buelowp/trainstation/pcb/village_control.brd

## EAGLE design pcb/village_control.brd (2020-09-09)

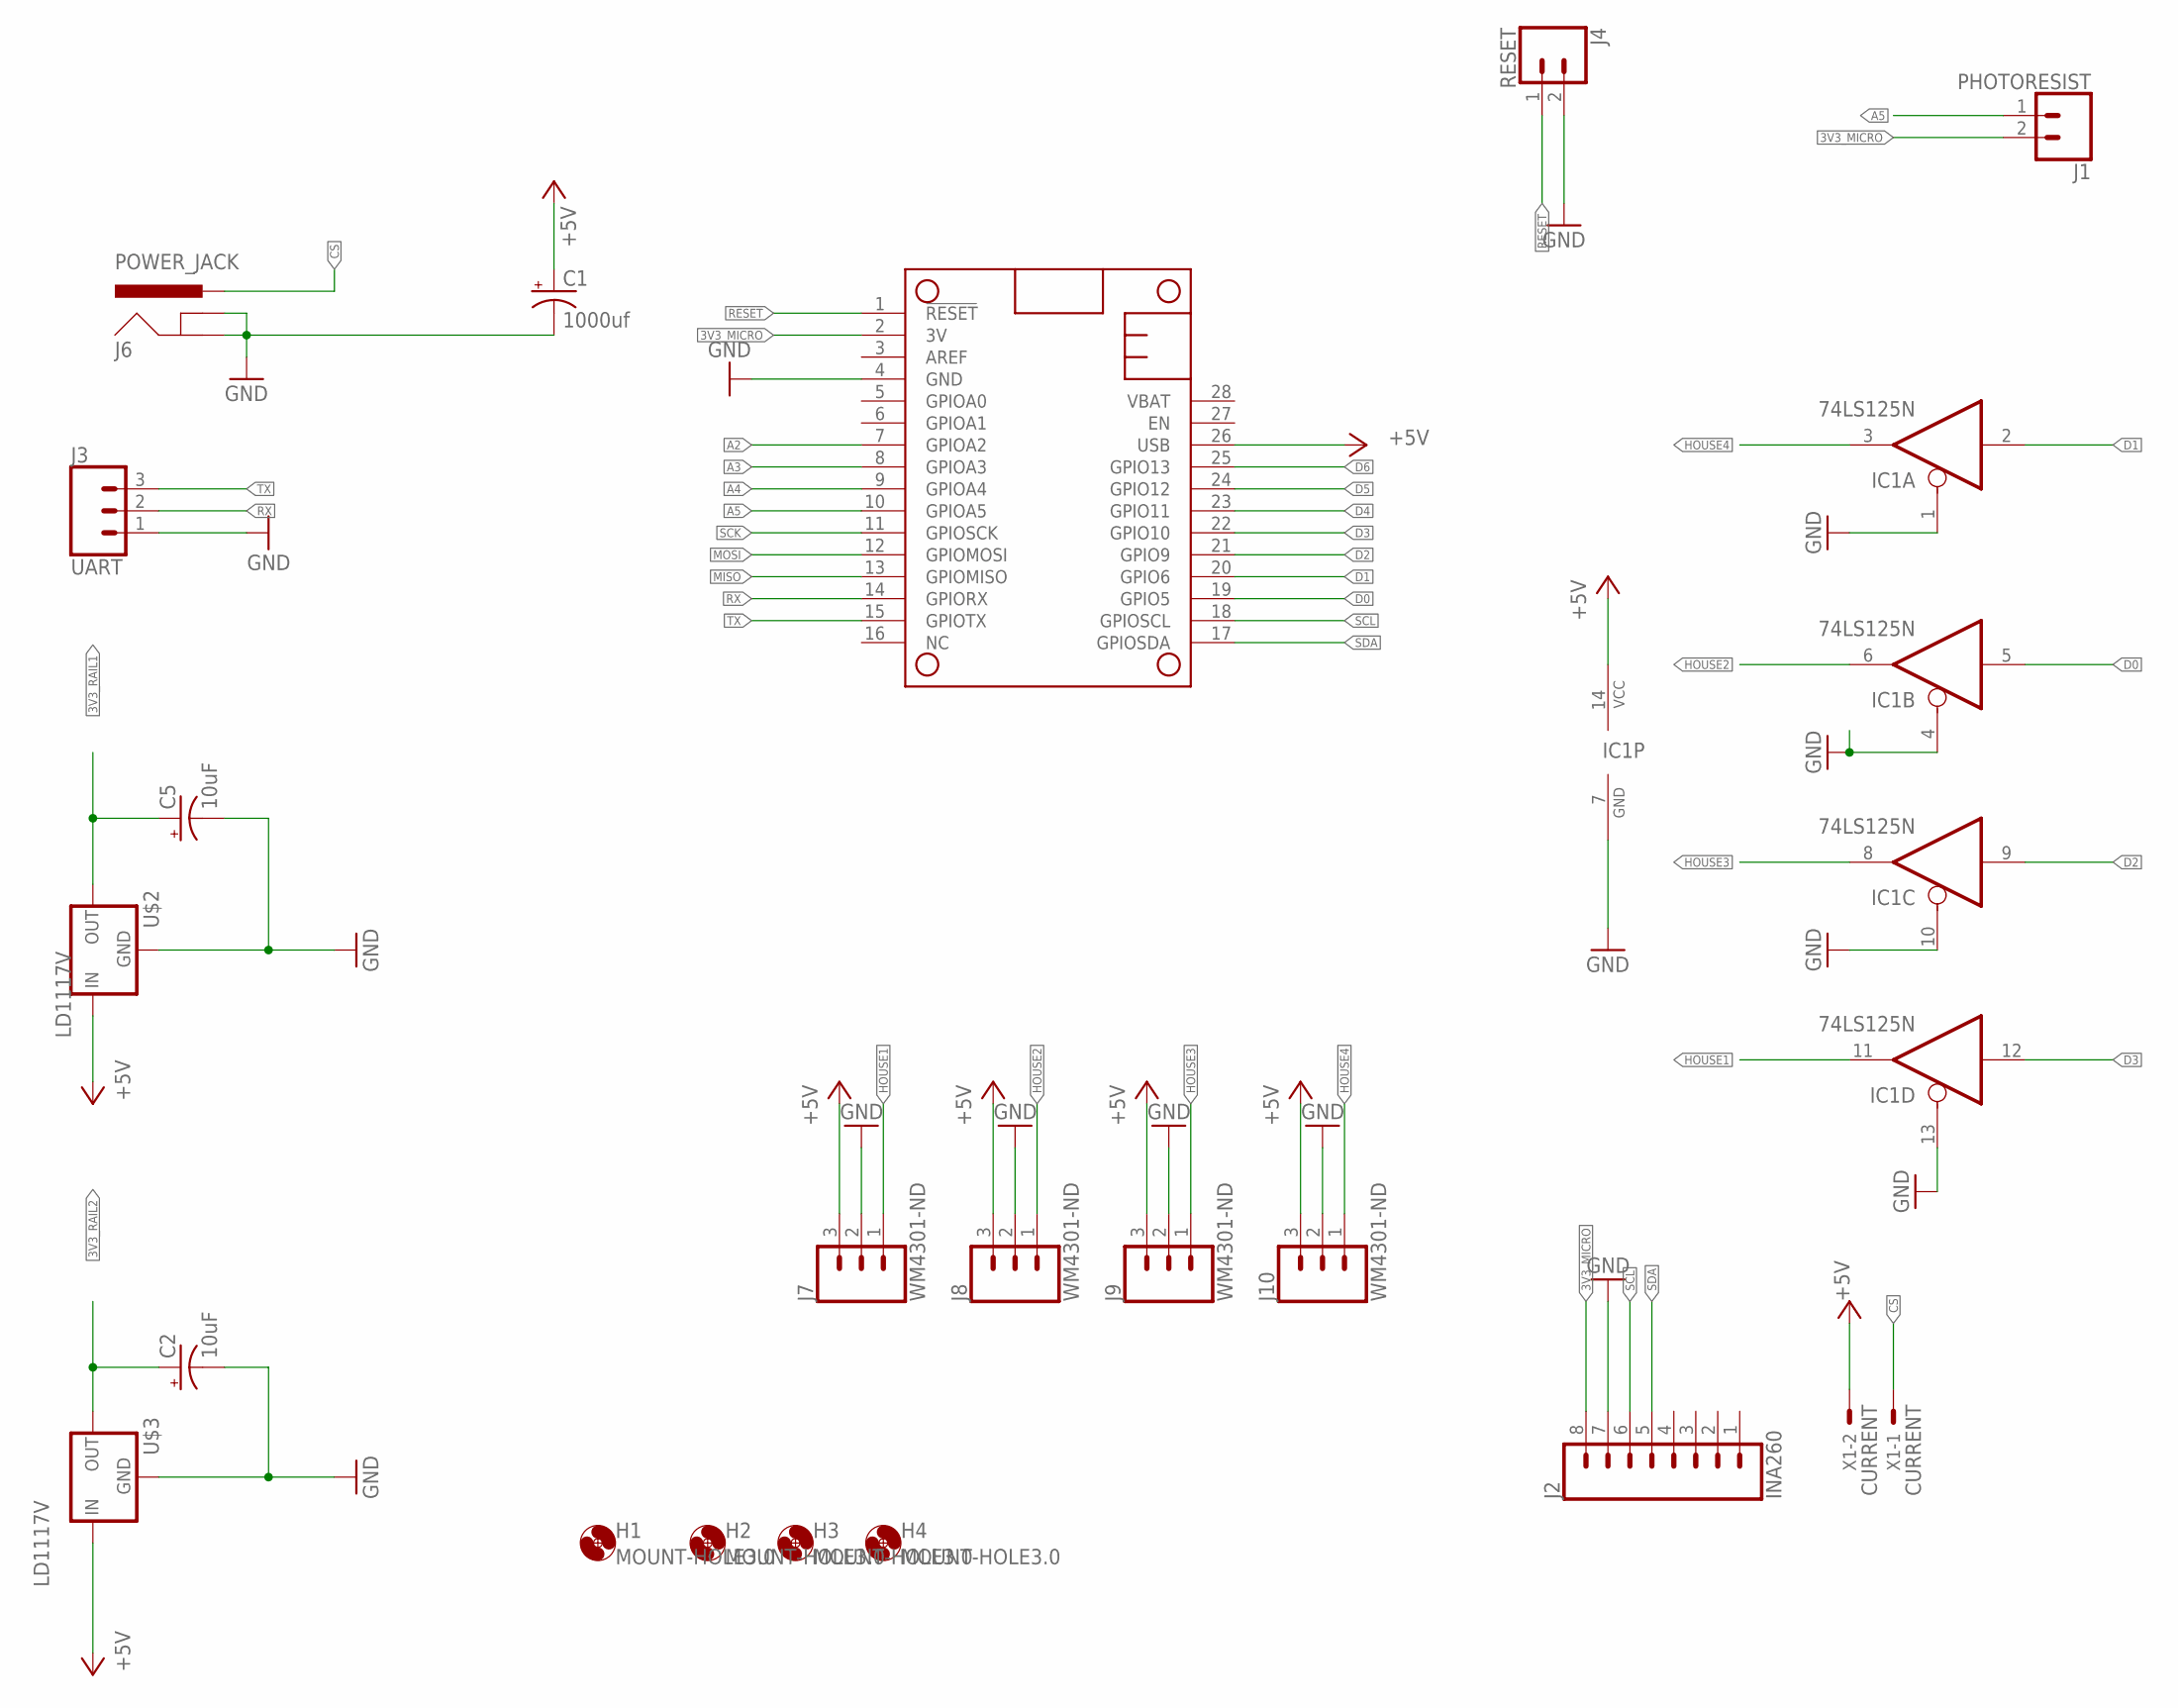
[picture p1: schematic village_control.sch, sheet 1]

Parts:
C1: 1000uf; CPOL-RADIAL-5MM-10MM
C2, C5: 10uF; CPOL-RADIAL-2.5MM-5MM-KIT
H1, H2, H3, H4: MOUNT-HOLE3.0; 3,0
IC1: 74LS125N; DIL14
J1: PHOTORESIST; 1X02
J2: INA260; 1X08
J3: UART; 1X03
J4: RESET; 1X02
J6: POWER_JACK; POWER_JACK_PTH
J7, J8, J9, J10: WM4301-ND; 1X03
MS2: FEATHERWING_NODIM; FEATHERWING_DIM
U$2, U$3: LD1117V; 78XXL
X1: CURRENT; KK-156-2

Connections:
3V3_MICRO: J1.2, J2.8, MS2.2 (3V)
3V3_RAIL1: C5.1 (+), U$2.GND (OUT); also elsewhere on the board
3V3_RAIL2: C2.1 (+), U$3.GND (OUT); also elsewhere on the board
+5V: C1.+, IC1.14 (VCC), J7.3, J8.3, J9.3, J10.3, MS2.26 (USB), U$2.OUT (IN), U$3.OUT (IN), X1.2; also elsewhere on the board
A2: MS2.7 (GPIOA2); also elsewhere on the board
A3: MS2.8 (GPIOA3); also elsewhere on the board
A4: MS2.9 (GPIOA4); also elsewhere on the board
A5: J1.1, MS2.10 (GPIOA5)
CS: J6.PWR, X1.1
D0: IC1.5 (I), MS2.19 (GPIO5)
D1: IC1.2 (I), MS2.20 (GPIO6)
D2: IC1.9 (I), MS2.21 (GPIO9)
D3: IC1.12 (I), MS2.22 (GPIO10)
D4: MS2.23 (GPIO11); also elsewhere on the board
D5: MS2.24 (GPIO12); also elsewhere on the board
D6: MS2.25 (GPIO13); also elsewhere on the board
GND: C1.-, C2.2 (-), C5.2 (-), IC1.1 (OE), IC1.4 (OE), IC1.7 (GND), IC1.10 (OE), IC1.13 (OE), J2.7, J3.1, J4.2, J6.GND, J6.GNDBREAK, J7.2, J8.2, J9.2, J10.2, MS2.4 (GND), U$2.IN (GND), U$3.IN (GND); also elsewhere on the board
HOUSE1: IC1.11 (O), J7.1
HOUSE2: IC1.6 (O), J8.1
HOUSE3: IC1.8 (O), J9.1
HOUSE4: IC1.3 (O), J10.1
MISO: MS2.13 (GPIOMISO); also elsewhere on the board
MOSI: MS2.12 (GPIOMOSI); also elsewhere on the board
RESET: J4.1, MS2.1 (!RESET)
RX: J3.2, MS2.14 (GPIORX)
SCK: MS2.11 (GPIOSCK); also elsewhere on the board
SCL: J2.6, MS2.18 (GPIOSCL)
SDA: J2.5, MS2.17 (GPIOSDA)
TX: J3.3, MS2.15 (GPIOTX)

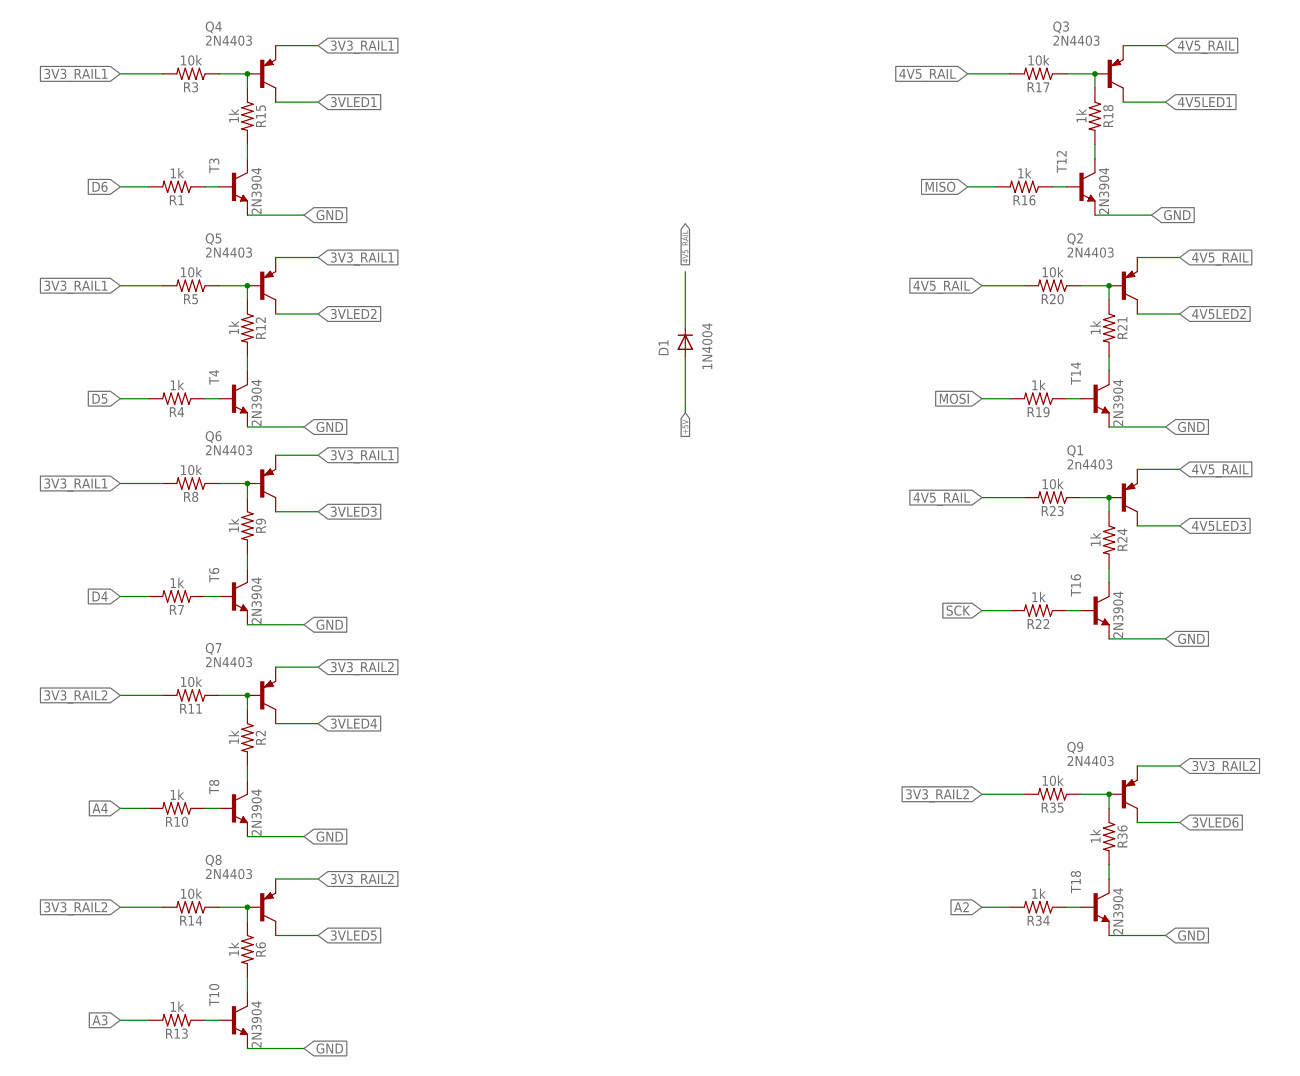
[picture p2: schematic village_control.sch, sheet 2]

Parts:
D1: 1N4004; DO41-10
Q1: 2n4403; TO92
Q2, Q3, Q4, Q5, Q6, Q7, Q8, Q9: 2N4403; TO92
R1, R2, R4, R6, R7, R9, R10, R12, R13, R15, R16, R18, R19, R21, R22, R24, R34, R36: 1k; AXIAL-0.3
R3, R5, R8, R11, R14, R17, R20, R23, R35: 10k; AXIAL-0.3
T3, T4, T6, T8, T10, T12, T14, T16, T18: 2N3904; TO92

Connections:
3V3_RAIL1: Q4.3 (E), Q5.3 (E), Q6.3 (E), R3.P$2 (2), R5.P$2 (2), R8.P$2 (2); also elsewhere on the board
3V3_RAIL2: Q7.3 (E), Q8.3 (E), Q9.3 (E), R11.P$2 (2), R14.P$2 (2), R35.P$2 (2); also elsewhere on the board
3VLED1: Q4.1 (C); also elsewhere on the board
3VLED2: Q5.1 (C); also elsewhere on the board
3VLED3: Q6.1 (C); also elsewhere on the board
3VLED4: Q7.1 (C); also elsewhere on the board
3VLED5: Q8.1 (C); also elsewhere on the board
3VLED6: Q9.1 (C); also elsewhere on the board
4V5LED1: Q3.1 (C); also elsewhere on the board
4V5LED2: Q2.1 (C); also elsewhere on the board
4V5LED3: Q1.1 (C); also elsewhere on the board
4V5_RAIL: D1.C, Q1.3 (E), Q2.3 (E), Q3.3 (E), R17.P$2 (2), R20.P$2 (2), R23.P$2 (2)
+5V: D1.A; also elsewhere on the board
A2: R34.P$2 (2); also elsewhere on the board
A3: R13.P$2 (2); also elsewhere on the board
A4: R10.P$2 (2); also elsewhere on the board
D4: R7.P$2 (2); also elsewhere on the board
D5: R4.P$2 (2); also elsewhere on the board
D6: R1.P$2 (2); also elsewhere on the board
GND: T3.3 (E), T4.3 (E), T6.3 (E), T8.3 (E), T10.3 (E), T12.3 (E), T14.3 (E), T16.3 (E), T18.3 (E); also elsewhere on the board
MISO: R16.P$2 (2); also elsewhere on the board
MOSI: R19.P$2 (2); also elsewhere on the board
unnamed: Q4.2 (B), R3.P$1 (1), R15.P$1 (1)
unnamed: R9.P$2 (2), T6.1 (C)
unnamed: R4.P$1 (1), T4.2 (B)
unnamed: R2.P$2 (2), T8.1 (C)
unnamed: R7.P$1 (1), T6.2 (B)
unnamed: R6.P$2 (2), T10.1 (C)
unnamed: Q6.2 (B), R8.P$1 (1), R9.P$1 (1)
unnamed: R12.P$2 (2), T4.1 (C)
unnamed: R10.P$1 (1), T8.2 (B)
unnamed: R1.P$1 (1), T3.2 (B)
unnamed: Q7.2 (B), R2.P$1 (1), R11.P$1 (1)
unnamed: R15.P$2 (2), T3.1 (C)
unnamed: R13.P$1 (1), T10.2 (B)
unnamed: Q8.2 (B), R6.P$1 (1), R14.P$1 (1)
unnamed: R36.P$2 (2), T18.1 (C)
unnamed: R16.P$1 (1), T12.2 (B)
unnamed: Q5.2 (B), R5.P$1 (1), R12.P$1 (1)
unnamed: Q3.2 (B), R17.P$1 (1), R18.P$1 (1)
unnamed: R24.P$2 (2), T16.1 (C)
unnamed: R19.P$1 (1), T14.2 (B)
unnamed: Q2.2 (B), R20.P$1 (1), R21.P$1 (1)
unnamed: R21.P$2 (2), T14.1 (C)
unnamed: R22.P$1 (1), T16.2 (B)
unnamed: Q1.2 (B), R23.P$1 (1), R24.P$1 (1)
unnamed: R18.P$2 (2), T12.1 (C)
unnamed: R34.P$1 (1), T18.2 (B)
unnamed: Q9.2 (B), R35.P$1 (1), R36.P$1 (1)
SCK: R22.P$2 (2); also elsewhere on the board

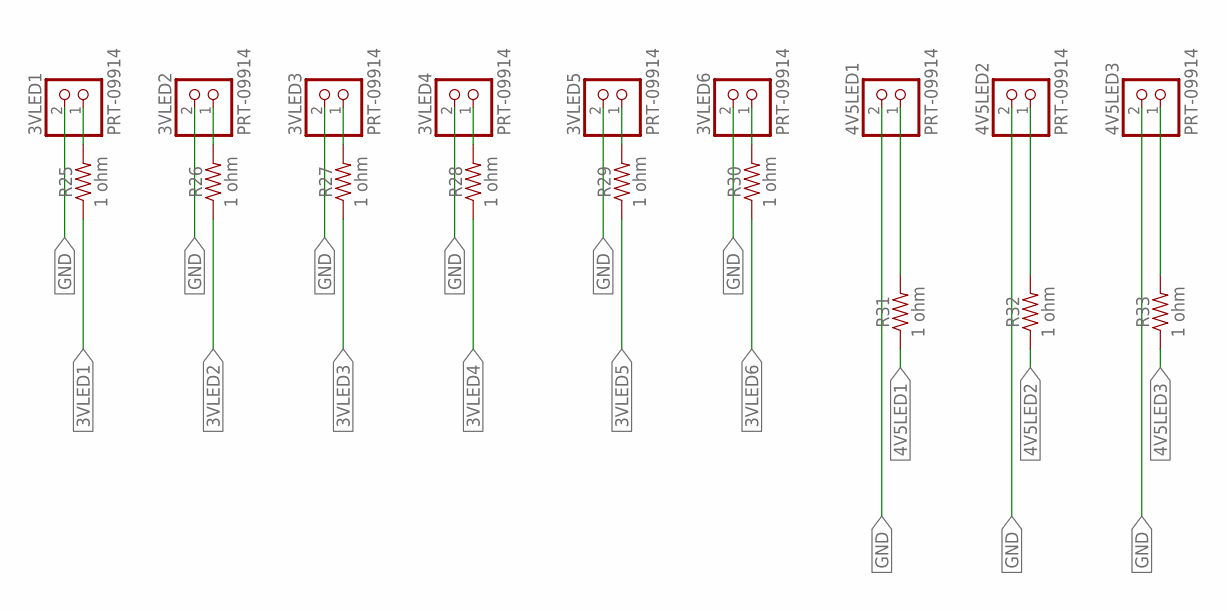
[picture p3: schematic village_control.sch, sheet 3]

Parts:
3VLED1, 3VLED2, 3VLED3, 3VLED4, 3VLED5, 3VLED6, 4V5LED1, 4V5LED2, 4V5LED3: PRT-09914; JST-PH-2-THM
R25, R26, R27, R28, R29, R30, R31, R32, R33: 1 ohm; AXIAL-0.3

Connections:
3VLED1: R25.P$1 (1); also elsewhere on the board
3VLED2: R26.P$1 (1); also elsewhere on the board
3VLED3: R27.P$1 (1); also elsewhere on the board
3VLED4: R28.P$1 (1); also elsewhere on the board
3VLED5: R29.P$1 (1); also elsewhere on the board
3VLED6: R30.P$1 (1); also elsewhere on the board
4V5LED1: R31.P$1 (1); also elsewhere on the board
4V5LED2: R32.P$1 (1); also elsewhere on the board
4V5LED3: R33.P$1 (1); also elsewhere on the board
GND: 3VLED1.2 (1), 3VLED2.2 (1), 3VLED3.2 (1), 3VLED4.2 (1), 3VLED5.2 (1), 3VLED6.2 (1), 4V5LED1.2 (1), 4V5LED2.2 (1), 4V5LED3.2 (1); also elsewhere on the board
unnamed: 3VLED1.1 (2), R25.P$2 (2)
unnamed: 4V5LED1.1 (2), R31.P$2 (2)
unnamed: 3VLED2.1 (2), R26.P$2 (2)
unnamed: 4V5LED2.1 (2), R32.P$2 (2)
unnamed: 3VLED3.1 (2), R27.P$2 (2)
unnamed: 4V5LED3.1 (2), R33.P$2 (2)
unnamed: 3VLED4.1 (2), R28.P$2 (2)
unnamed: 3VLED5.1 (2), R29.P$2 (2)
unnamed: 3VLED6.1 (2), R30.P$2 (2)

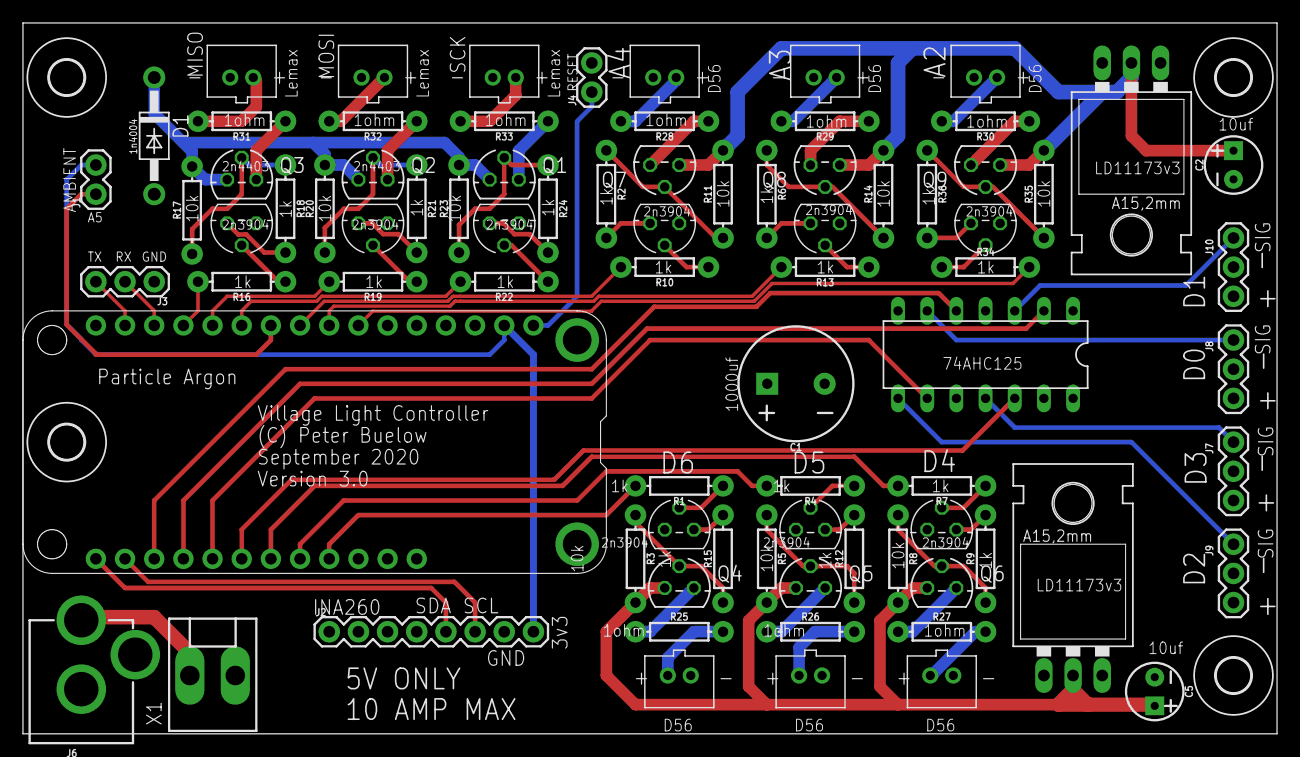
[picture p4: board village_control.brd from above]

Board: 4 copper layers, 109.2 x 61.9 mm, 85 parts (0 on the bottom side), 75 nets.
