buelowp/trainstation/(commit log)

2020-04-17 blink was running full bore, it never switched.
2020-09-07 Checkpoint
    * Fixed it so the lights do what we need them to
    * Seperated the FastLED and Adafruit connections into classes to make it easier to manage the different parts
    * Added new gitignore
    [house.h, station.cpp, station.h, trainstation.ino]
2020-09-07 Checkpoint
    * Added a block class to handle a collection of houses
    * Fixed up houses with logging and a few logical changes
    * Modified loop() to turn houses on and off randomly I believe, still testing
    [block.h, houses.h, station.cpp, trainstation.ino]
2020-09-08 New functionality
    * Added the ability to control the individual LED pins, which are street lamps mostly
    * Fixed a lot of bugs with the houses, and blocks of houses logic
    * Fixed a lot of logic related to turning on and off houses around sunrise and sunset
    [block.h, houses.h, lamp.cpp, lamp.h, lamps.cpp, lamps.h, station.cpp, trainstation.ino]
2020-09-08 Adding the controller PCB to the stored contents
    [village_control.brd, village_control.sch]
2020-09-09 Fixing a bug
    * I switched the parameters for hasBeenTested() in turnOffRandomHouse() which caused some issues
    * Made the 1 minute HB print one hour just cause
    [trainstation.ino]
2020-09-16 Lots of fixes.
    * Fixed bugs related to when lights turn on and off
    * Cleaned up logic issues
    * Made sure timeset only runs once
    [block.h, houses.h, station.cpp, station.h, trainstation.ino]
2020-09-18 Many fixes
    * Fixed an issue where the station didn't start correctly, so it wouldn't turn off
    * Fixed some indexing issues for the FastLED CRGB arrays
    * Many printing changes
    * Work towards fixing the number of lights that turn on/off in the random, still seems to have an issue
    [houses.h, station.cpp, station.h, trainstation.ino]
2020-10-13 Migrating to new house branch
    * Create a class structure to support both FastLED and Adafruit LEDs
2020-11-14 Updates
    * Fixed some issues related to turning signals on and off
    * Migrating to all Adafruit code for lighting
    [houses.h, trainstation.ino]
2020-11-15 Lots of fixes
    * Provide the houses base with a turnon + brightness
    * Fixed a bug in the ada houses which made sure they wouldn't turn on
    * Fix turning houses off if lights are still no after 10
    [fastledhouses.cpp, fastledhouses.h, houses.h, station.cpp, trainstation.ino]
2020-11-16 Fixes issues and gets it working
    * Changed how I determine which houses can be turned on for random
    * Fixed bugs in the houses
    * Added MQTT messaging to make it easier to see what's happening
    [block.h, fastledhouses.h, houses.h, trainstation.ino]
2020-11-18 Fixing some issues
    * Add village.* to git, it was missing before
    * Fix issues turning lights on/off correctly
    * Added some new methods for house control
    * Fixed issues with RGBW support for houses
    [trainstation.ino, village.cpp, village.h]
